raunakroboticsai/CICSE-2026/Hardware/Schematic_CISCE-2026-Competition-FINAL_2026-09-19.pdf

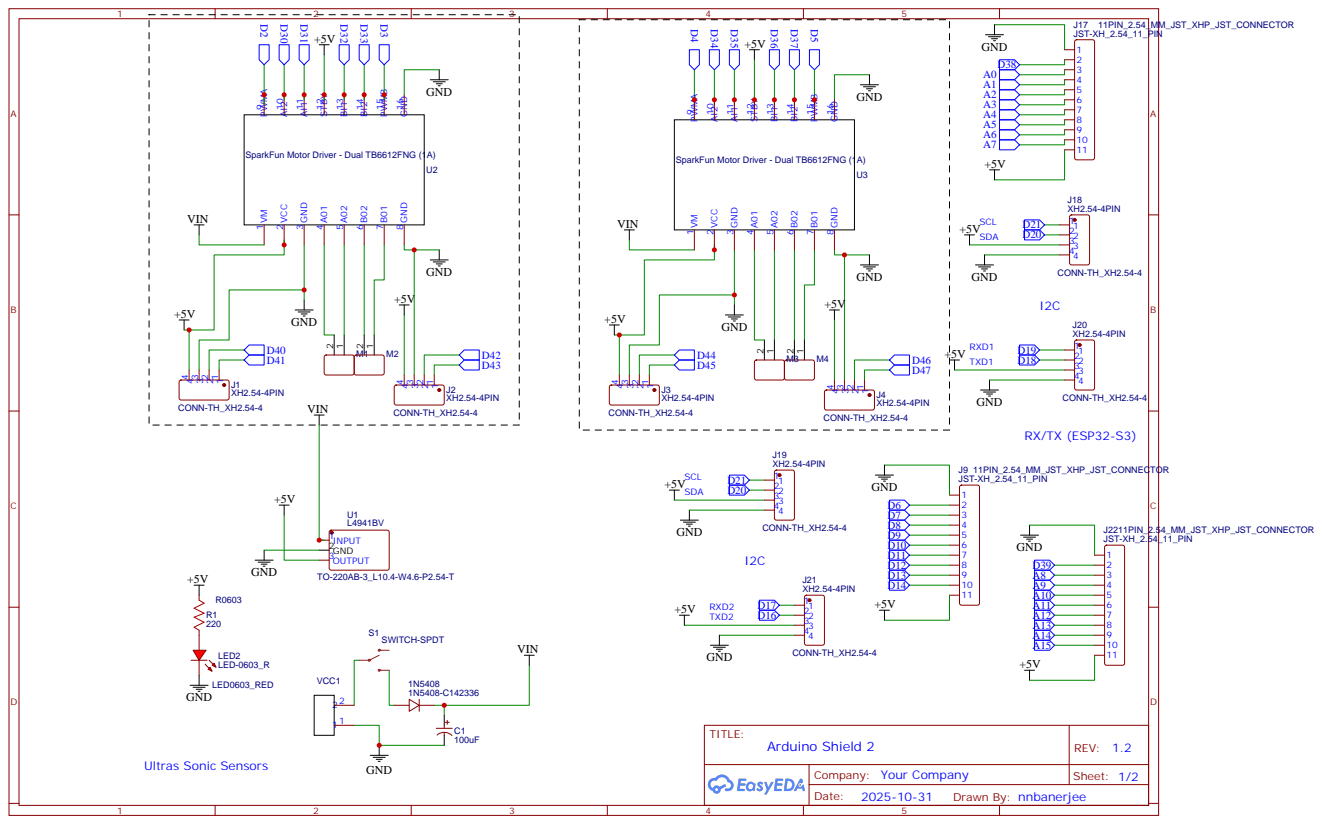
[picture p1: page 1]

SparkFun Motor Driver - Dual TB6612FNG (1A)

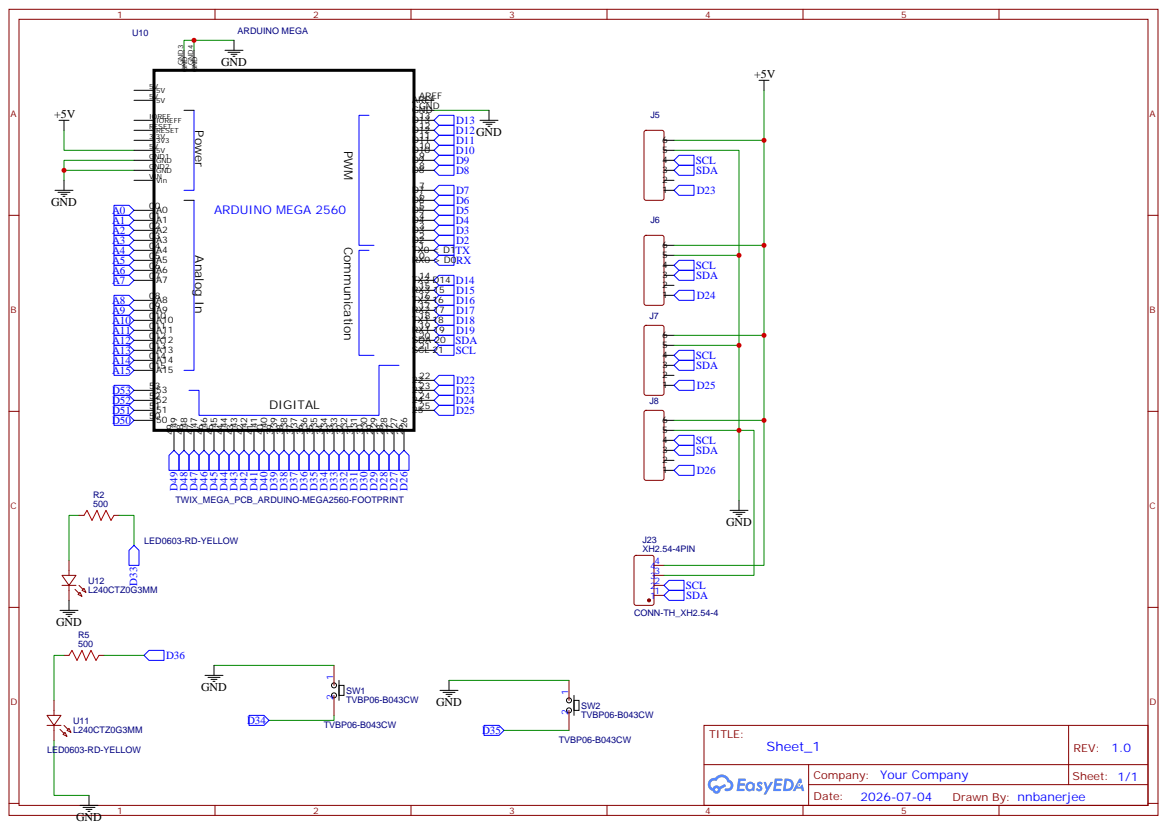
[picture p2: page 2]
