raunakroboticsai/CICSE-2026/TestingProgram/Motor/Motortest.ino

// =====================================================
// MECANUM MOTOR TEST
// Arduino Mega 2560 + 2x TB6612FNG
//
// U2 = M1, M2
// U3 = M3, M4
//
// STBY = Hard-wired to +5V
// =====================================================


// ---------- U2 ----------
#define M1_PWM  2
#define M1_IN1  31
#define M1_IN2  30

#define M2_PWM  3
#define M2_IN1  32
#define M2_IN2  33


// ---------- U3 ----------
#define M3_PWM  4
#define M3_IN1  35
#define M3_IN2  34

#define M4_PWM  5
#define M4_IN1  36
#define M4_IN2  37


#define SPEED 150
#define MOVE_TIME 2500


// =====================================================
// MOTOR 1
// =====================================================

void motor1(int speed) {

  if (speed > 0) {
    digitalWrite(M1_IN1, HIGH);
    digitalWrite(M1_IN2, LOW);
  }
  else if (speed < 0) {
    digitalWrite(M1_IN1, LOW);
    digitalWrite(M1_IN2, HIGH);
  }
  else {
    digitalWrite(M1_IN1, LOW);
    digitalWrite(M1_IN2, LOW);
  }

  analogWrite(M1_PWM, abs(speed));
}


// =====================================================
// MOTOR 2
// =====================================================

void motor2(int speed) {

  if (speed > 0) {
    digitalWrite(M2_IN1, HIGH);
    digitalWrite(M2_IN2, LOW);
  }
  else if (speed < 0) {
    digitalWrite(M2_IN1, LOW);
    digitalWrite(M2_IN2, HIGH);
  }
  else {
    digitalWrite(M2_IN1, LOW);
    digitalWrite(M2_IN2, LOW);
  }

  analogWrite(M2_PWM, abs(speed));
}


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

  // M4
  pinMode(M4_PWM, OUTPUT);
  pinMode(M4_IN1, OUTPUT);
  pinMode(M4_IN2, OUTPUT);

  stopMotors();

  delay(1000);
}


// =====================================================
// MAIN TEST SEQUENCE
// =====================================================

void loop() {

  // -----------------------------------------------
  // 1. FORWARD
  // -----------------------------------------------

  forward();
  delay(MOVE_TIME);

  stopMotors();
  delay(500);


  // -----------------------------------------------
  // 2. BACKWARD
  // -----------------------------------------------

  backward();
  delay(MOVE_TIME);

  stopMotors();
  delay(500);


  // -----------------------------------------------
  // 3. STRAFE RIGHT
  // -----------------------------------------------

  strafeRight();
  delay(MOVE_TIME);

  stopMotors();
  delay(500);


  // -----------------------------------------------
  // 4. STRAFE LEFT
  // -----------------------------------------------

  strafeLeft();
  delay(MOVE_TIME);

  stopMotors();
  delay(500);


  // -----------------------------------------------
  // 5. ROTATE RIGHT
  // -----------------------------------------------

  rotateRight();
  delay(MOVE_TIME);

  stopMotors();
  delay(500);


  // -----------------------------------------------
  // 6. ROTATE LEFT
  // -----------------------------------------------

  rotateLeft();
  delay(MOVE_TIME);

  stopMotors();
  delay(500);


  // -----------------------------------------------
  // 7. DIAGONAL FRONT-RIGHT
  // -----------------------------------------------

  diagonalFrontRight();
  delay(MOVE_TIME);

  stopMotors();
  delay(500);


  // -----------------------------------------------
  // 8. DIAGONAL FRONT-LEFT
  // -----------------------------------------------

  diagonalFrontLeft();
  delay(MOVE_TIME);

  stopMotors();
  delay(500);


  // -----------------------------------------------
  // 9. DIAGONAL BACK-RIGHT
  // -----------------------------------------------

  diagonalBackRight();
  delay(MOVE_TIME);

  stopMotors();
  delay(500);


  // -----------------------------------------------
  // 10. DIAGONAL BACK-LEFT
  // -----------------------------------------------

  diagonalBackLeft();
  delay(MOVE_TIME);

  stopMotors();

  // Wait before repeating
  delay(2000);
}
