raunakroboticsai/CICSE-2026/(commit log)

2026-09-25 Create physical motor locations are confirmed
2026-09-27 Update physical motor locations are confirmed
